Targett363/Xmas_Star_21/README.md

# Xmas_Star_21
PCB for Xmas 2021

Branched KiCAD repo to check the feasability of diferent MCUs and shift registers
