Targett363/Xmas_Star_21/XMAS_Star_21.kicad_pcb

## KiCad design XMAS_Star_21.kicad_pcb (2021-01-08)

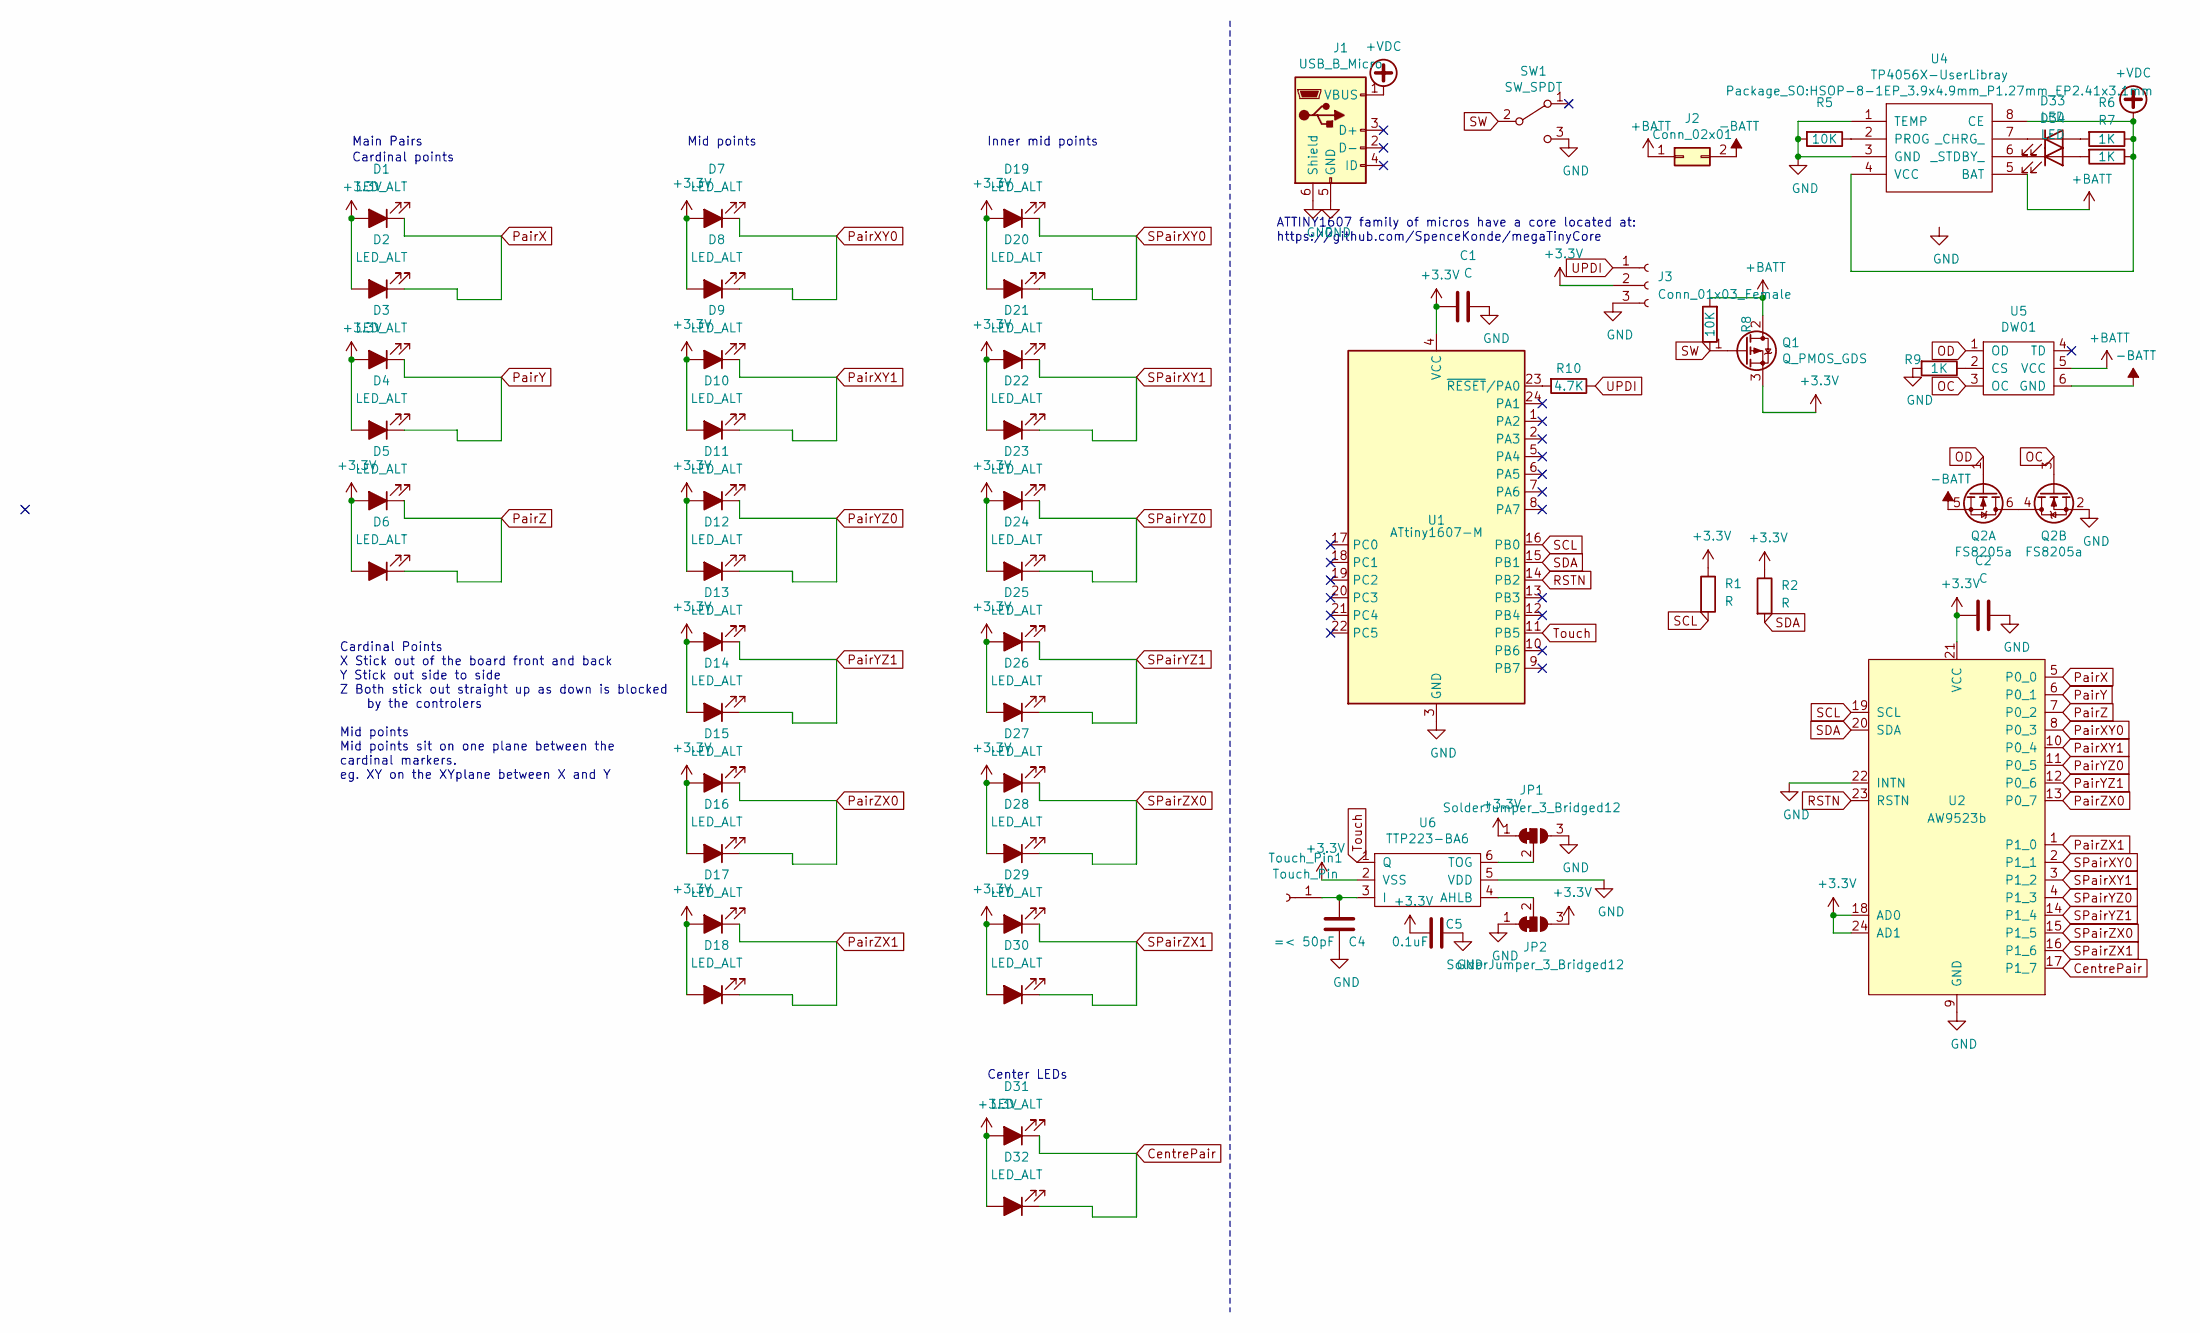
[picture p1: schematic XMAS_Star_21.sch]

Parts:
C1, C2: C; C_0603_1608Metric
C4: =< 50pF; C_0603_1608Metric
C5: 0.1uF; C_0603_1608Metric
D1, D2, D3, D4, D5, D6, D7, D8, D9, D10, D11, D12, D13, D14, D15, D16, D17, D18, D19, D20, D21, D22, D23, D24, D25, D26, D27, D28, D29, D30: LED_ALT; PinHeader_1x02_P1.00mm_Vertical
D31, D32: LED_ALT; LED_0603_1608Metric
D33, D34: LED; LED_0603_1608Metric_Castellated
J1: USB_B_Micro; USB_Micro-B_Molex_47346-0001
J2: Conn_02x01; JST_PH_S2B-PH-K_1x02_P2.00mm_Horizontal
J3: Conn_01x03_Female; PinSocket_1x03_P2.54mm_Vertical
JP1, JP2: SolderJumper_3_Bridged12; SolderJumper-3_P1.3mm_Bridged12_RoundedPad1.0x1.5mm_NumberL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
Q1: Q_PMOS_GDS; TO-252-2
Q2: FS8205a; SOT-23-6
R1, R2: R; R_0603_1608Metric
R5, R8: 10K; R_0603_1608Metric
R6, R7, R9: 1K; R_0603_1608Metric
R10: 4.7K; R_0603_1608Metric
SW1: SW_SPDT; SW_SPDT_PCM12
Touch_Pin1: Touch_Pin; PinHeader_1x01_P1.00mm_Vertical
U1: ATtiny1607-M; QFN-24-1EP_4x4mm_P0.5mm_EP2.6x2.6mm
U2: AW9523b; QFN-24-1EP_4x4mm_P0.5mm_EP2.7x2.7mm_ThermalVias
U4: TP4056X-UserLibray; HSOP-8-1EP_3.9x4.9mm_P1.27mm_EP2.41x3.1mm
U5: DW01; SOT-23-6
U6: TTP223-BA6; SOT-23-6

Connections:
+3V3: C1.2, C2.2, C5.2, D1.2 (A), D2.2 (A), D3.2 (A), D4.2 (A), D5.2 (A), D6.2 (A), D7.2 (A), D8.2 (A), D9.2 (A), D10.2 (A), D11.2 (A), D12.2 (A), D13.2 (A), D14.2 (A), D15.2 (A), D16.2 (A), D17.2 (A), D18.2 (A), D19.2 (A), D20.2 (A), D21.2 (A), D22.2 (A), D23.2 (A), D24.2 (A), D25.2 (A), D26.2 (A), D27.2 (A), D28.2 (A), D29.2 (A), D30.2 (A), D31.2 (A), D32.2 (A), J3.2, JP1.1 (A), JP2.3 (B), Q1.3 (S), R1.1, R2.1, U1.4 (VCC), U2.18 (AD0), U2.21 (VCC), U2.24 (AD1), U6.2 (VSS)
+BATT: J2.1, Q1.2 (D), R8.2, U4.5 (BAT), U5.5 (VCC)
+VDC: J1.1 (VBUS), R6.1, R7.1, U4.4 (VCC), U4.8 (CE)
-BATT: J2.2, Q2.5 (S), U5.6 (GND)
CentrePair: D31.1 (K), D32.1 (K), U2.17 (P1_7)
GND: C1.1, C2.1, C4.1, C5.1, J1.5 (GND), J1.6 (Shield), J3.3, JP1.3 (B), JP2.1 (A), Q2.2 (S), R5.2, R9.2, SW1.3 (C), U1.3 (GND), U1.25 (GND), U2.9 (GND), U2.22 (INTN), U2.25 (GND), U4.1 (TEMP), U4.3 (GND), U4.9 (GND), U6.5 (VDD)
unnamed: C4.2, Touch_Pin1.1, U6.3 (I)
unnamed: D33.1 (K), U4.7 (_CHRG_)
unnamed: D33.2 (A), R6.2
unnamed: D34.1 (K), U4.6 (_STDBY_)
unnamed: D34.2 (A), R7.2
unnamed: JP1.2 (C), U6.6 (TOG)
unnamed: JP2.2 (C), U6.4 (AHLB)
unnamed: Q2.4 (D), Q2.6 (D)
unnamed: R5.1, U4.2 (PROG)
unnamed: R9.1, U5.2 (CS)
unnamed: R10.2, U1.23 (~RESET~/PA0)
OC: Q2.3 (G), U5.3 (OC)
OD: Q2.1 (G), U5.1 (OD)
PairX: D1.1 (K), D2.1 (K), U2.5 (P0_0)
PairXY0: D7.1 (K), D8.1 (K), U2.8 (P0_3)
PairXY1: D9.1 (K), D10.1 (K), U2.10 (P0_4)
PairY: D3.1 (K), D4.1 (K), U2.6 (P0_1)
PairYZ0: D11.1 (K), D12.1 (K), U2.11 (P0_5)
PairYZ1: D13.1 (K), D14.1 (K), U2.12 (P0_6)
PairZ: D5.1 (K), D6.1 (K), U2.7 (P0_2)
PairZX0: D15.1 (K), D16.1 (K), U2.13 (P0_7)
PairZX1: D17.1 (K), D18.1 (K), U2.1 (P1_0)
RSTN: U1.14 (PB2), U2.23 (RSTN)
SCL: R1.2, U1.16 (PB0), U2.19 (SCL)
SDA: R2.2, U1.15 (PB1), U2.20 (SDA)
SPairXY0: D19.1 (K), D20.1 (K), U2.2 (P1_1)
SPairXY1: D21.1 (K), D22.1 (K), U2.3 (P1_2)
SPairYZ0: D23.1 (K), D24.1 (K), U2.4 (P1_3)
SPairYZ1: D25.1 (K), D26.1 (K), U2.14 (P1_4)
SPairZX0: D27.1 (K), D28.1 (K), U2.15 (P1_5)
SPairZX1: D29.1 (K), D30.1 (K), U2.16 (P1_6)
SW: Q1.1 (G), R8.1, SW1.2 (B)
Touch: U1.11 (PB5), U6.1 (Q)
UPDI: J3.1, R10.1

Notes on the sheet:
Main Pairs
Cardinal points
Mid points
Cardinal Points X Stick out of the board front and back Y Stick out side to side Z Both stick out straight up as down is blocked by the controlers Mid points Mid points sit on one plane between the cardinal markers. eg. XY on the XYplane between X and Y
Inner mid points
Center LEDs
ATTINY1607 family of micros have a core located at: https://github.com/SpenceKonde/megaTinyCore

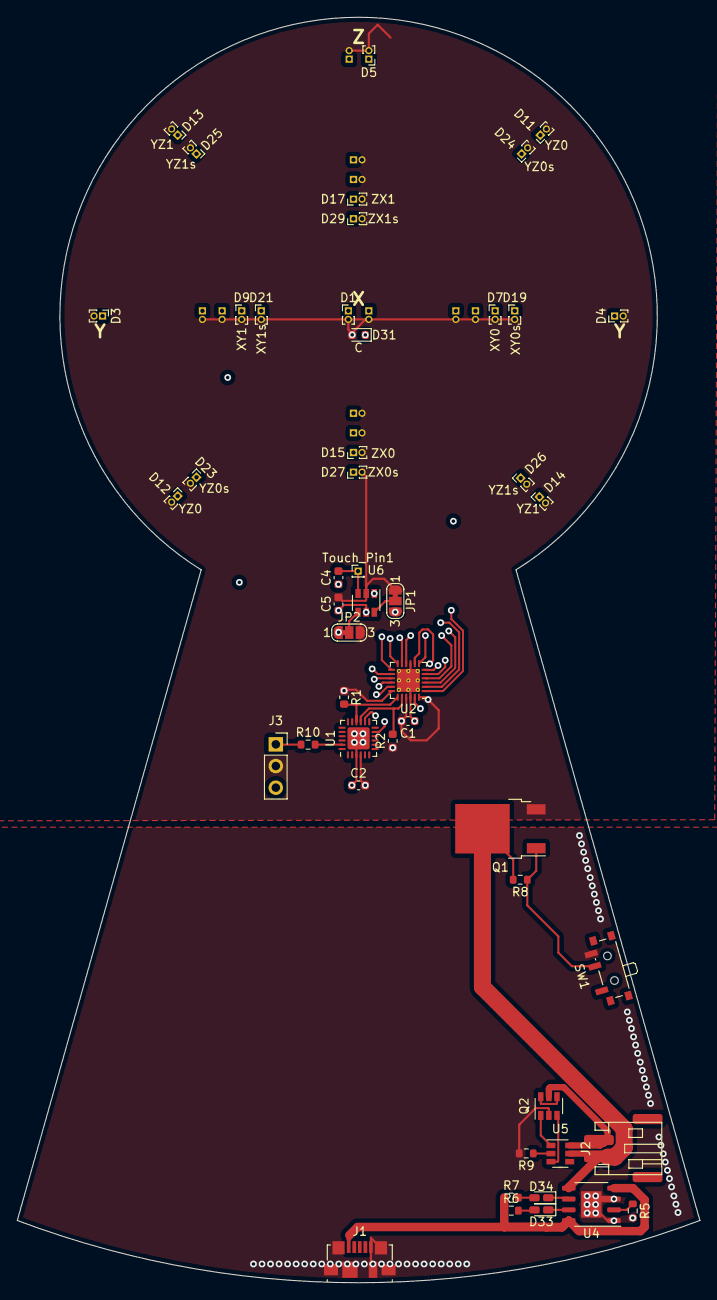
[picture p2: board XMAS_Star_21.kicad_pcb from above]

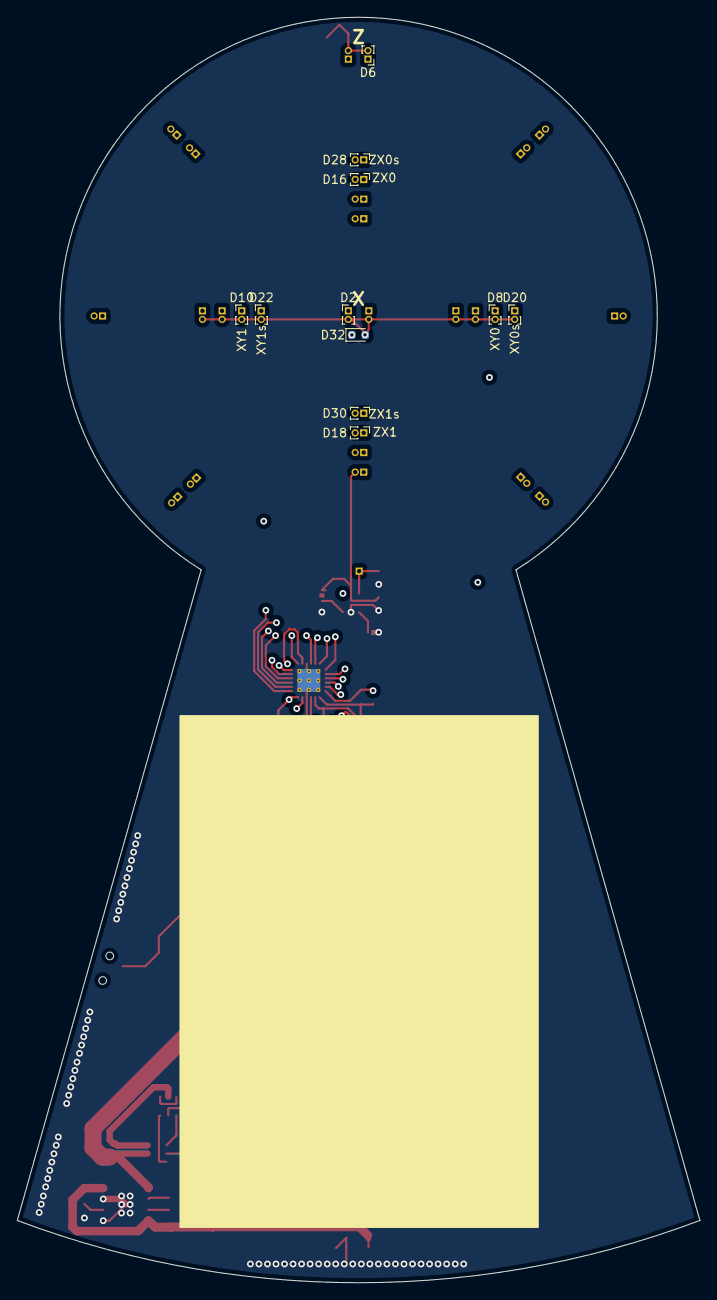
[picture p3: board XMAS_Star_21.kicad_pcb from below]

Board: 4 copper layers, 80.0 x 148.3 mm, 60 parts (11 on the bottom side), 40 nets.
