Targett363/Xmas_Star_21/(commit log)

2021-01-01 Initial Star files
    [XMAS_Star_21.kicad_pcb, XMAS_Star_21.sch]
2021-01-01 cleaning autosaves
    [XMAS_Star_21.kicad_pcb]
2021-01-01 Swapping the shift register for AW9523b
    [XMAS_Star_21.sch]
2021-01-01 Added AW9523b and required nets to schematic
    [XMAS_Star_21.sch]
2021-01-01 Added AW9523b and routing to PCB
    [XMAS_Star_21.kicad_pcb, XMAS_Star_21.sch]
2021-01-06 cleaned up UDPI connector
    [XMAS_Star_21.kicad_pcb, XMAS_Star_21.sch]
2021-01-06 tidy power to ICs and start code
    [XMAS_Star_21.kicad_pcb, XMAS_Star_21.sch]
2021-01-06 hashing out the shape of the Arduino flow
2021-01-06 Remembering to put pullups on the i2cgit add --all
    [XMAS_Star_21.kicad_pcb, XMAS_Star_21.sch]
2021-01-07 further shaping of the code and change TTP223 from direct to toggle output
    [XMAS_Star_21.kicad_pcb, XMAS_Star_21.sch]
2021-01-07 updated interrupt in code for the change of TTP223 from direct to toggle output
2021-01-08 adding the i2c transmit animation function and making it work
2021-01-08 Gerbers made, zipped and sent
    [XMAS_Star_21-B_Cu.gbr, XMAS_Star_21-B_Mask.gbr, XMAS_Star_21-B_Paste.gbr, XMAS_Star_21-B_SilkS.gbr, XMAS_Star_21-Edge_Cuts.gbr, XMAS_Star_21-F_Cu.gbr, XMAS_Star_21-F_Mask.gbr, XMAS_Star_21-F_Paste.gbr]
2021-01-08 fix silly curly brace mistake
    [Tiny1607_W_AW9523b.ino]
2021-01-18 Code updates, allow Animations to run forward and reverse, added Fade animation
    [Tiny1607_W_AW9523b.ino]
